Alansnuo/EnvMon_WIFI/APP/app_config.h

/* ============================================================================
 * 部署配置: 所有环境相关参数集中存放
 * 换 WiFi / 云平台只改本文件, 业务代码直接引用宏
 * ========================================================================== */

#ifndef __APP_CONFIG_H
#define __APP_CONFIG_H

/* ========================= WiFi ========================= */
#define CFG_WIFI_SSID         "奈何神明耍诈"
#define CFG_WIFI_PASSWORD     "G123456789"

/* ========================= MQTT (OneNET) ========================= */
#define CFG_MQTT_HOST         "mqtts.heclouds.com"
#define CFG_MQTT_PORT         1883
#define CFG_MQTT_CLIENT_ID    "test1"
#define CFG_MQTT_USERNAME     "v9cSbzDFqr"
#define CFG_MQTT_PASSWORD     "version=2018-10-31&res=products%2Fv9cSbzDFqr%2Fdevices%2Ftest1&et=1821308308&method=sha1&sign=9Cyhm1fn76GI5cURLVvT6AV4XCg%3D"
#define CFG_MQTT_KEEPALIVE_S  60

/* ===================== 上报主题 ===================== */
#define CFG_MQTT_PUB_TOPIC    "$sys/v9cSbzDFqr/test1/thing/property/post"

/* ===================== 阈值初值 (必做4: 超限告警) ===================== */
#define CFG_TH_TEMP_UP        35        /* ℃  高于此值 → 温度过高 */
#define CFG_TH_TEMP_DN        10        /* ℃  低于此值 → 温度过低 */
#define CFG_TH_HUMI_UP        90        /* %RH 高于此值 → 湿度过高 */
#define CFG_TH_HUMI_DN        30        /* %RH 低于此值 → 湿度过低 */
#define CFG_TH_LUX_DN         10        /* lx  低于此值 → 光照不足(光线偏暗) */
#define CFG_TH_LUX_UP         200       /* lx  高于此值 → 光照过强 */

#endif /* __APP_CONFIG_H */
