Alansnuo/EnvMon_WIFI/(commit log)

2026-09-26 初始提交：STM32F103 环境监测 WiFi 网关
2026-09-28 详解笔记不再发布：从仓库移除并加入 .gitignore
2026-09-28 README + 上报改成值变化才发
    - 新增 README.md：功能 / 数据流 / 接线 / 目录 / 设计取舍 / 编译 / 配置
    - task_wifi：采到的值拼成 JSON 和上次发成功的比一遍，一样就不发
    - esp8266：RST 引脚交给 CubeMX 配，extern huart2 移到头文件，注释精简
2026-09-28 上报报文独立成 app_json，WiFi 驱动按参考工程从简
    - 新增 APP/app_json.c/h：感应器的值攒成报文，值变化才发
    - 驱动去掉转义函数，转义符直接写进 app_json 的格式串
    - 四条 AT 命令各一句 snprintf(s_Cmd, sizeof(s_Cmd), ...)
    - 去掉参数 NULL 检查
    - Code=16512 RO-data=440 RW-data=168 ZI-data=13104
2026-10-12 加入光照和天问（暂存版）
2026-10-12 加入OLED
2026-10-12 去掉串口助手相关代码
2026-10-12 gui界面（暂定）
2026-10-13 oled汉字显示正常
2026-10-14 wifi连接显示
2026-10-14 oled显示功能完成（英文）
2026-10-14 oled去掉汉字优化
2026-10-14 功能完整
2026-10-14 加入超限闪烁灯
2026-10-14 mqtt上传光照数据
2026-10-15 优化驱动
2026-10-15 添加时间
2026-10-15 WiFi获取时间正常
2026-10-15 注释简洁化
2026-10-15 光照任务 每 2 秒才设一次亮度
2026-10-15 分步渐变灯光（fade）
2026-10-15 优化显示时间延迟问题
2026-10-16 注释优化
2026-10-16 修复引脚冲突BUG（PA6和PB5）
2026-10-17 修改提交.gitignore
2026-10-17 驱动优化
2026-10-19 队列加入光照
